Manaf941/ordinateur-8-bit-tm/Dossier TM/logisim-1.jpg

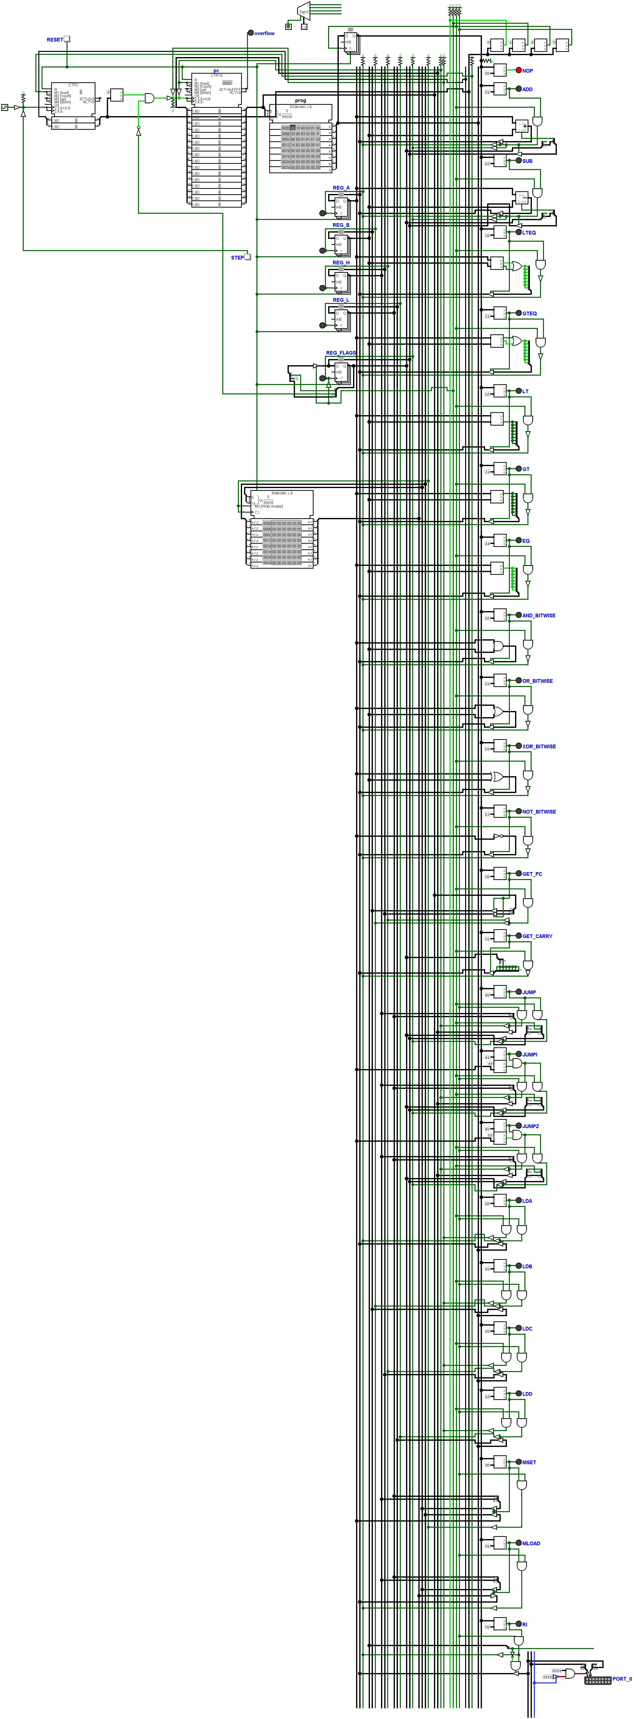
Dossier TM/logisim-1.jpg
