Manaf941/ordinateur-8-bit-tm/Dossier TM/État KiCad.pdf

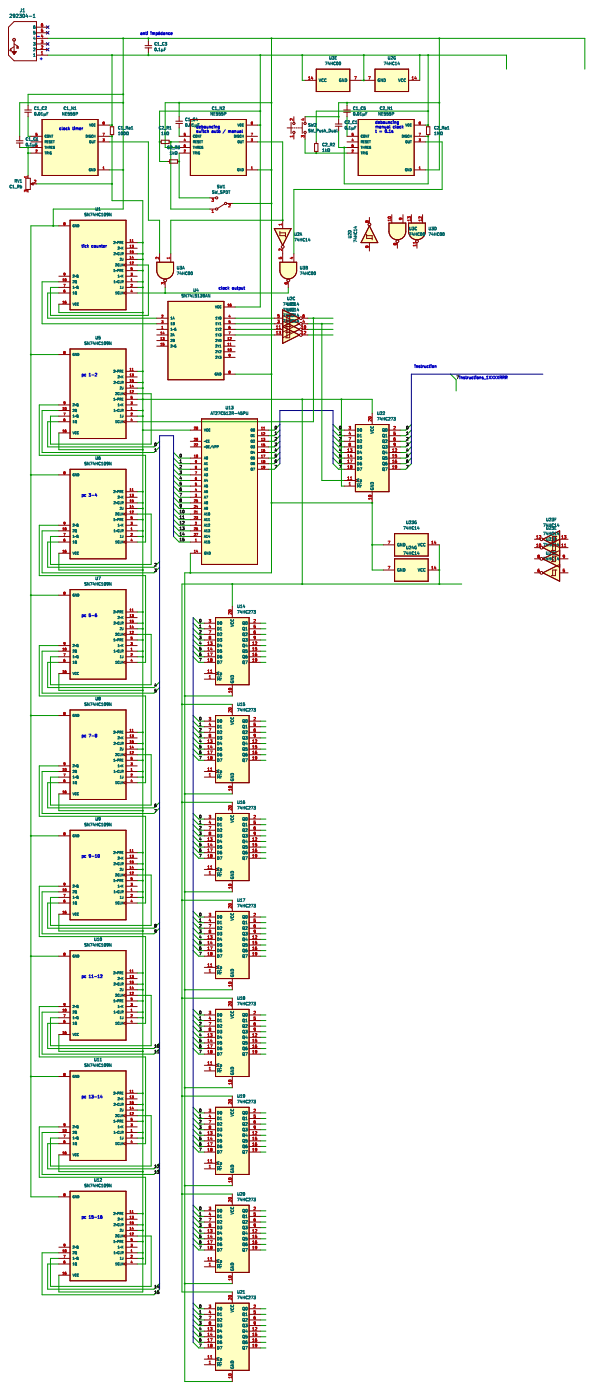
[picture p10: page 1]
