Manaf941/ordinateur-8-bit-tm/(list of files, drawings)

Other design files:
new.circ
