Manaf941/ordinateur-8-bit-tm/project/project.kicad_pcb

## KiCad design Hermes - Flight Controller.kicad_sch

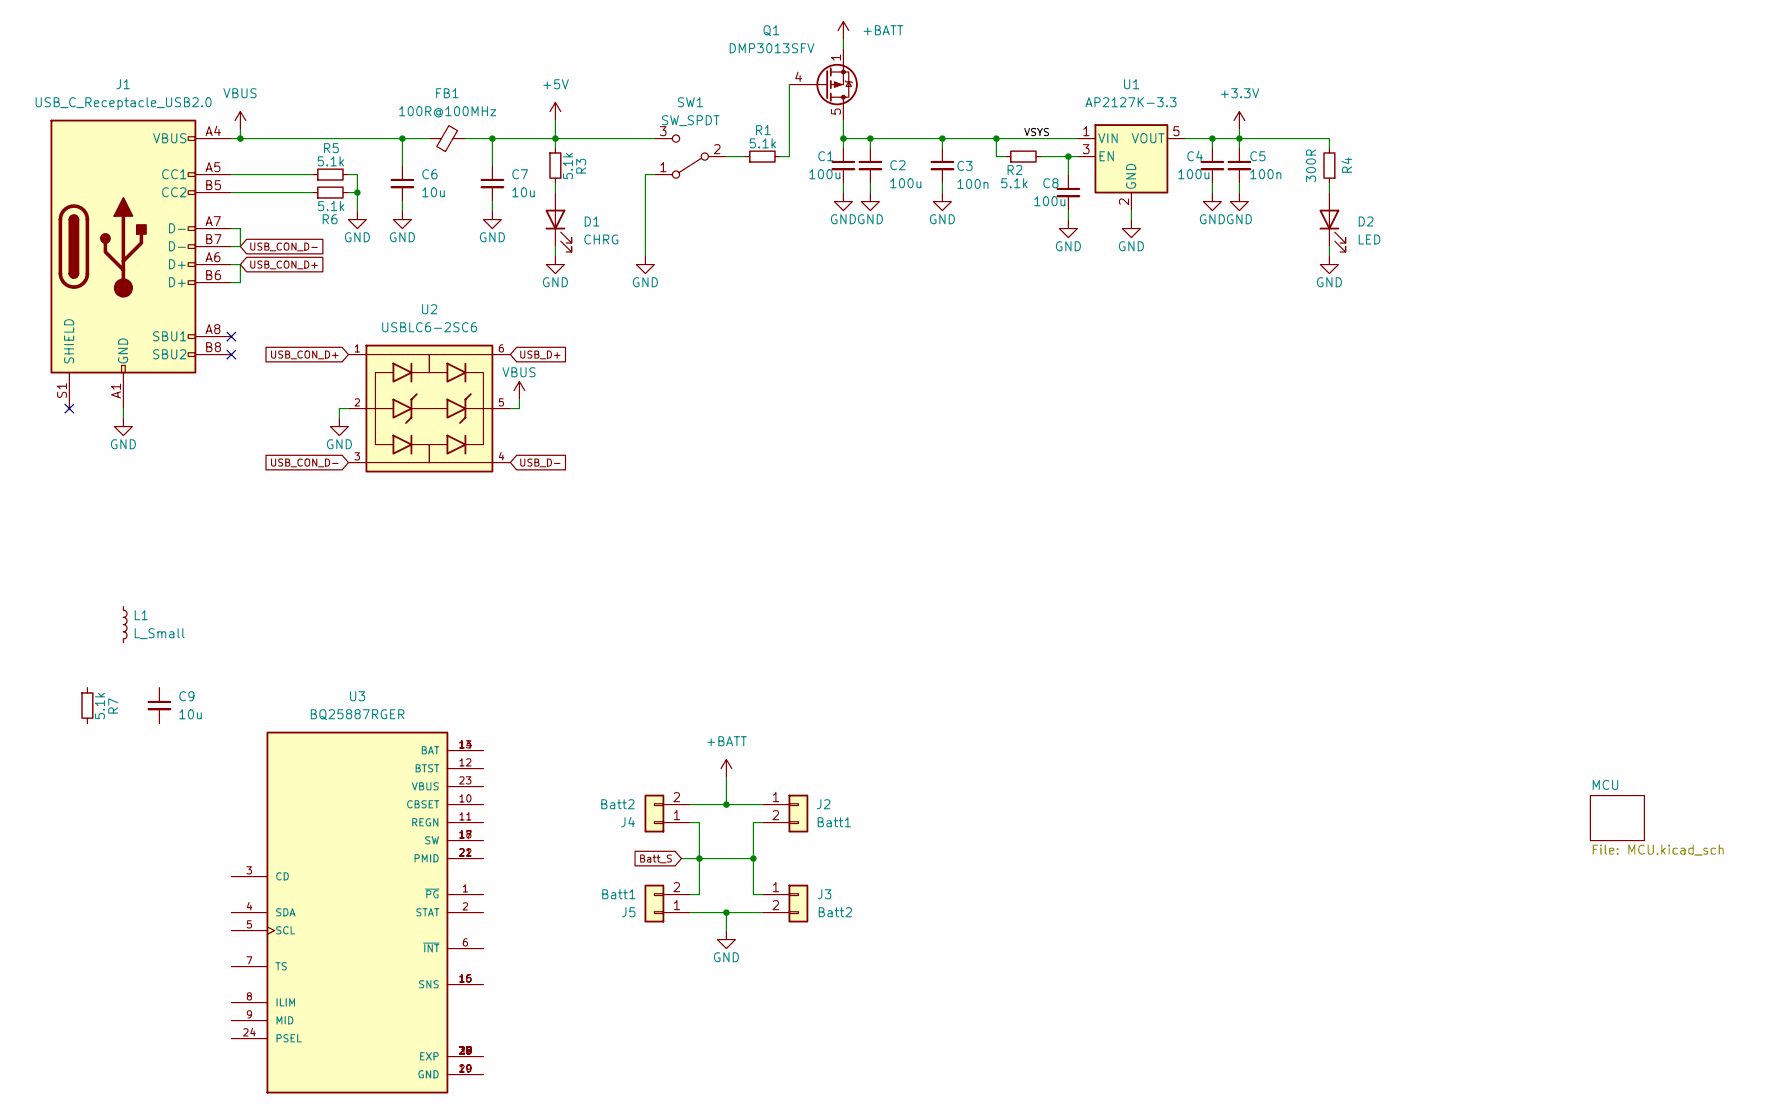
[picture p11: schematic Hermes - Flight Controller.kicad_sch]

Parts:
C1, C2, C4, C8: 100u; R_0805_2012Metric_Pad1.20x1.40mm_HandSolder
C3, C5: 100n; R_0603_1608Metric_Pad0.98x0.95mm_HandSolder
C6, C7, C9: 10u; C_0603_1608Metric_Pad1.08x0.95mm_HandSolder
D1: CHRG; LED_0603_1608Metric_Pad1.05x0.95mm_HandSolder
D2: LED; R_0603_1608Metric_Pad0.98x0.95mm_HandSolder
FB1: 100R@100MHz; R_0603_1608Metric_Pad0.98x0.95mm_HandSolder
J1: USB_C_Receptacle_USB2.0
J2, J5: Batt1
J3, J4: Batt2
L1: L_Small
Q1: DMP3013SFV; Diodes_PowerDI3333-8
R1, R2, R3, R5, R6, R7: 5.1k; R_0603_1608Metric_Pad0.98x0.95mm_HandSolder
R4: 300R; R_0603_1608Metric_Pad0.98x0.95mm_HandSolder
SW1: SW_SPDT
U1: AP2127K-3.3; SOT-23-5
U2: USBLC6-2SC6; SOT95P280X145-6N
U3: BQ25887RGER; IC_BQ25887RGER; PARTREV November 2019

Connections:
+3.3V: C4.1, C5.1, R4.2, U1.5 (VOUT)
+5V: C7.1, FB1.2, R3.1, SW1.3 (C)
+BATT: J2.1, J4.2, Q1.1 (S), Q1.2 (S), Q1.3 (S)
Batt_S: J2.2, J3.1, J4.1, J5.2
GND: C1.2, C2.2, C3.2, C4.2, C5.2, C6.2, C7.2, C8.2, D1.1 (K), D2.1 (K), J1.A1 (GND), J1.A12 (GND), J1.B1 (GND), J1.B12 (GND), J3.2, J5.1, R5.2, R6.2, SW1.1 (A), U1.2 (GND), U2.2
unnamed: C8.1, R2.2, U1.3 (EN)
unnamed: D1.2 (A), R3.2
unnamed: D2.2 (A), R4.1
unnamed: J1.A5 (CC1), R5.1
unnamed: J1.B5 (CC2), R6.1
unnamed: Q1.4 (G), R1.2
unnamed: R1.1, SW1.2 (B)
unnamed: U3.13 (BAT), U3.14 (BAT)
unnamed: U3.15 (SNS), U3.16 (SNS)
unnamed: U3.17 (SW), U3.18 (SW)
unnamed: U3.19 (GND), U3.20 (GND)
unnamed: U3.21 (PMID), U3.22 (PMID)
unnamed: U3.25 (EXP), U3.26 (EXP), U3.27 (EXP), U3.28 (EXP), U3.29 (EXP), U3.30 (EXP)
USB_CON_D+: J1.A6 (D+), J1.B6 (D+), U2.1
USB_CON_D-: J1.A7 (D-), J1.B7 (D-), U2.3
USB_D+: U2.6
USB_D-: U2.4
VBUS: C6.1, FB1.1, J1.A4 (VBUS), J1.A9 (VBUS), J1.B4 (VBUS), J1.B9 (VBUS), U2.5
VSYS: C1.1, C2.1, C3.1, Q1.5 (D), R2.1, U1.1 (VIN)
