Manaf941/ordinateur-8-bit-tm/(commit log)

2023-02-23 + d'instructions
    [BACKUP.circ]
2023-02-23 Table d'instruction
    [BACKUP.circ, project.circ]
2023-02-23 Petit fix
    [project.circ]
2023-02-23 JUMPZ fix
    [project.circ]
2023-03-16 register table, basic assembly compiler
    [project.circ]
2023-03-16 fix LD+JUMP, add instruction register
    [project.circ]
2023-03-30 update proj
    [project.circ]
2023-05-04 Remove project.circ
    [project.circ]
2023-05-19 new instruction table, ram, remove pc and 5 ticks
    [new.circ]
2023-10-10 Update repo
    [new.circ]
2023-10-10 Upload PCB Schema (05.10.23)
    [project.kicad_pcb, project.kicad_sch]
2023-11-07 Remove third multiplexer
    [new.circ]
